torfinns/Autotrim/analysis/calibration_analysis.png

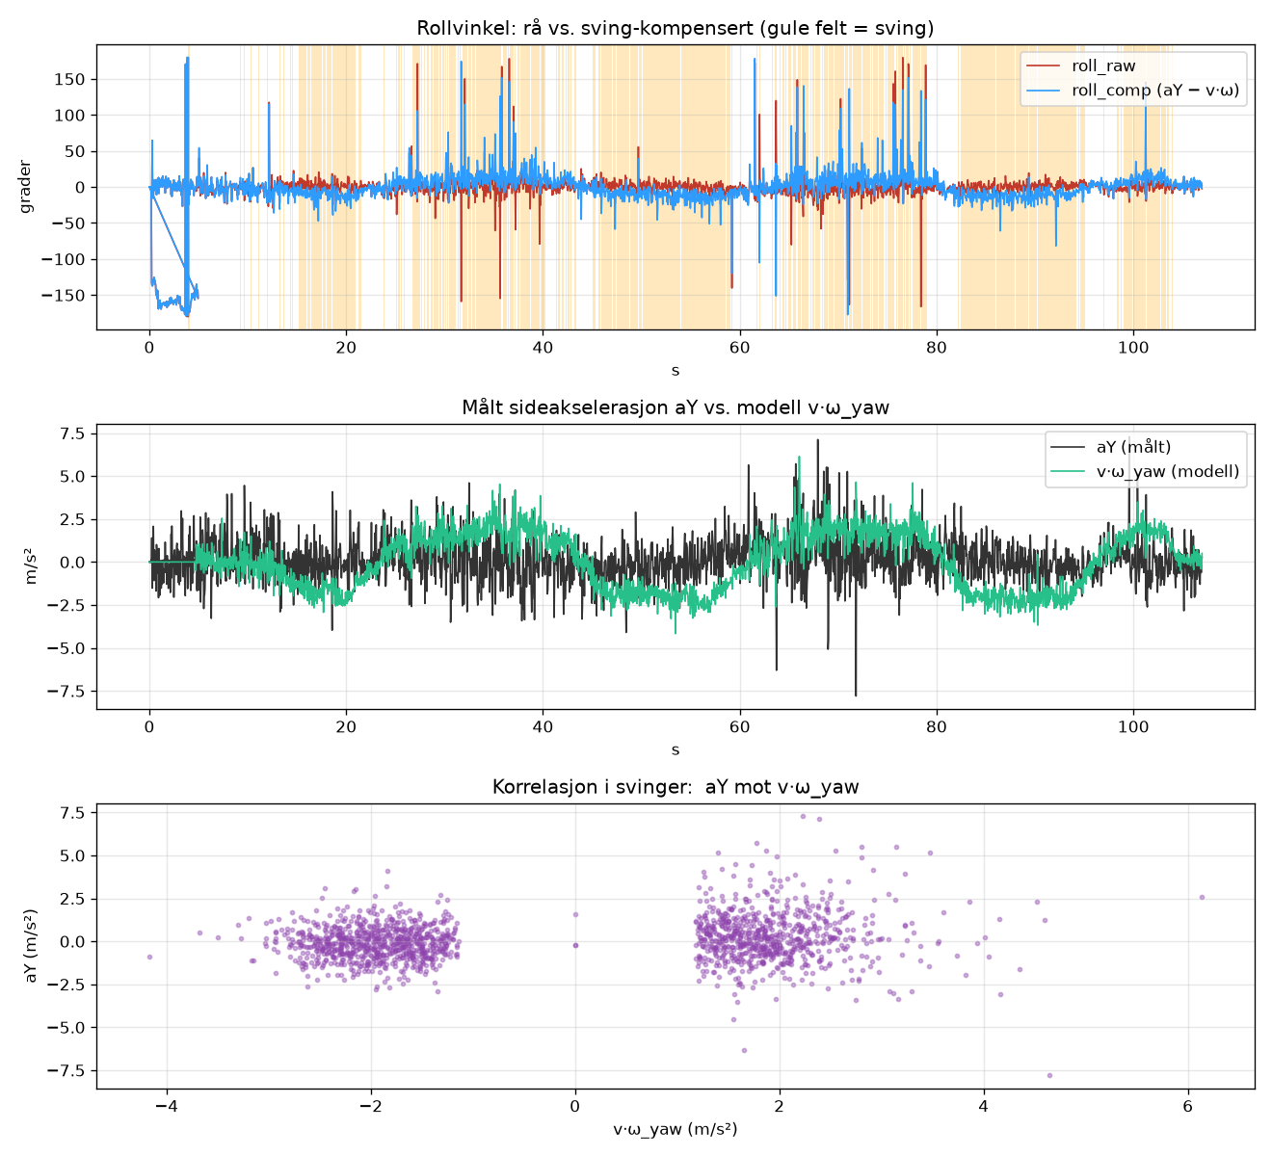
analysis/calibration_analysis.png
