torfinns/Autotrim/analysis/calibration_analysis_med5.png

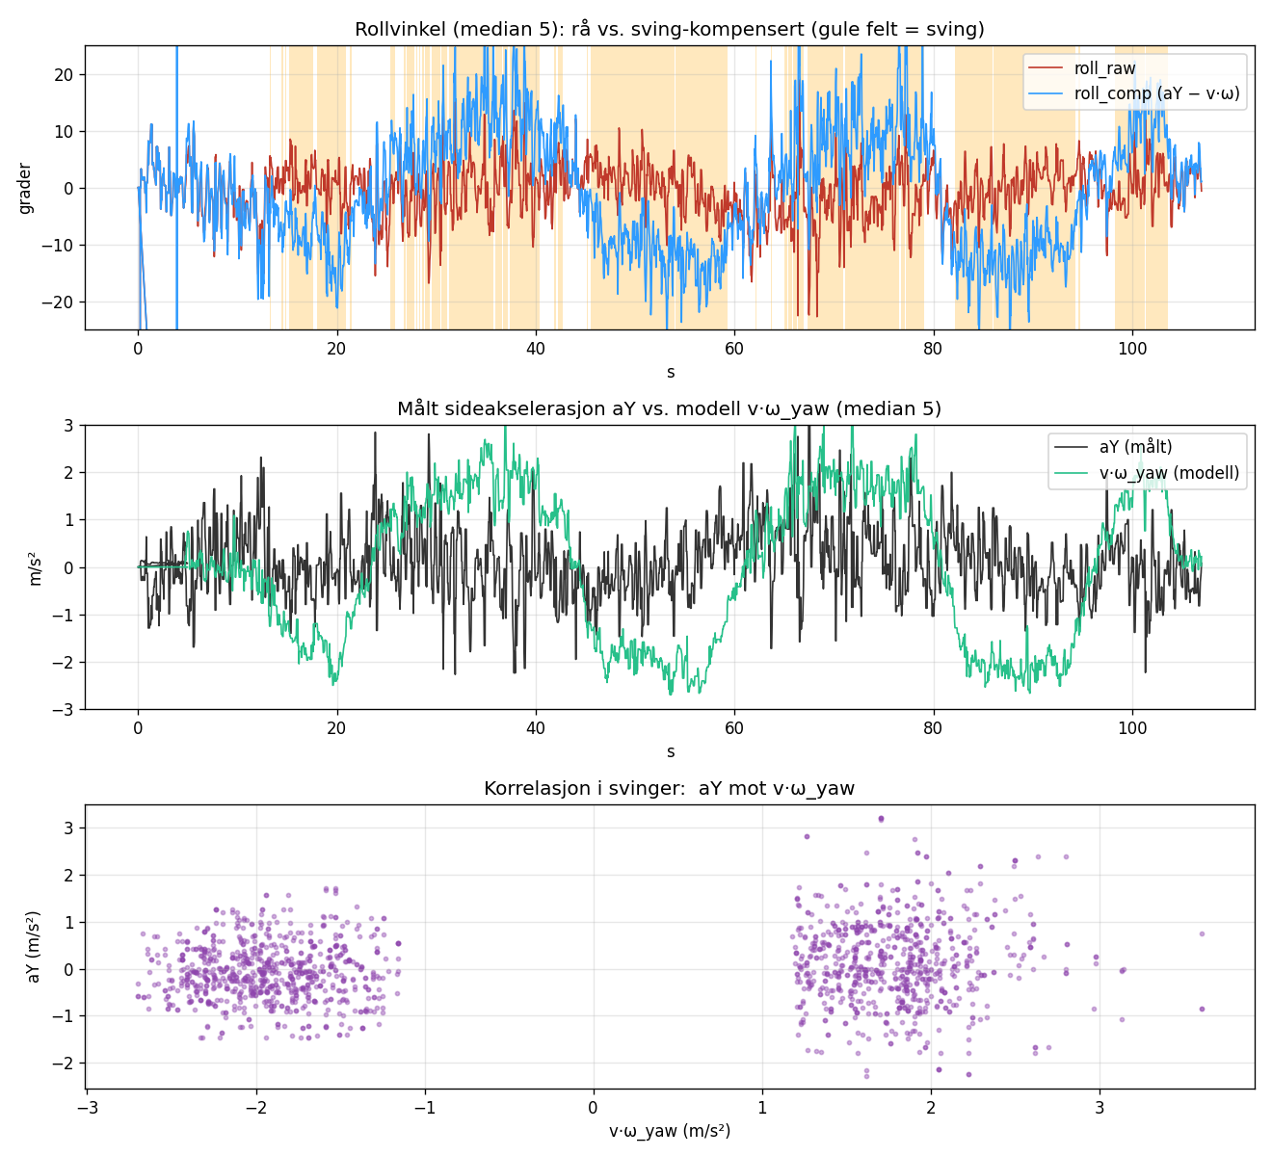
analysis/calibration_analysis_med5.png
