torfinns/Autotrim/(commit log)

2026-06-27 Fiks NimBLE-krasj: bruk 2.5.0 lokalt + NVS-recovery med restart
    Kopierer NimBLE-Arduino 2.5.0 til sketch-lokal libraries/ (system
    hadde 2.1.3 som krasjer med esp32-core 3.3.10 pga. mu->handle NULL
    i createServer). Auto-recovery sletter NVS og kaller ESP.restart()
    ved krasj slik at neste boot starter helt fra scratch.
2026-06-27 Legg til monteringsoffset, dotfill-streker og preset-meny
    - Firmware: AutotrimParams struct +4 bytes (mountingOffsetDeg float @ offset 52), PARAMS_VERSION→2
    - Firmware: offset brukes i telemetri, kontrollloop og serial debug
    - GUI: dotfill-streker mellom parameternavn og verdi i alle rader
    - GUI: ny parameter-rad for Monteringsoffset (°)
    - GUI: nedtrekksmeny med tre preset-sett (Fabrikk/Sport/Glatt)
    - GUI: PARAM_FIELDS og ArrayBuffer oppdatert til 56 bytes
2026-06-27 Gjør rollSign/gyroSign redigerbare i GUI
    Erstatter read-only visning med dropdown (-1/+1).
    loadParams() og buildParams() lese/skriver int8 ved offset 48/49.
2026-06-27 Minimum pådragstid 500ms; GUI: pos-bars vertikale; Drift+Test slått sammen; kP/kI ×100
    - Firmware: hold-timer per retning, 500ms min pådragstid i kontrollsløyfe
    - GUI: planposisjon vises som grønn strek fra topp → ned
    - GUI: Drift og Test slått til én fieldset, relay-knapper større, ingen Stopp-alle
    - GUI: kP og kI vises ×100 (GUI=6.0 → firmware 0.06); PARAM_FIELDS med scale-faktor
    - GUI: preset-verdier oppdatert til ny skala
    [autotrim_v1.ino]
2026-06-27 GUI: fjern Reléer-kort; relay-knapper lyser grønt; LEFT/RIGHT/NEUTRAL
    - Reléer-ramme fjernet fra dashboard
    - Relay-knapper lyser grønt når aktivt (manuelt eller automatikk)
    - Knapper: LEFT UP/DOWN, RIGHT UP/DOWN
    - Nøytralknapp: NEUTRAL / HOME
    - Les på nytt → Les parametre
    - fFlags flyttet til Tilstand-kortet
2026-06-27 Fjern gyroSign — firmware bruker rollSign for begge akser
    gyroSign var redundant og kunne føre til at gyro og akselerometer
    motarbeidet hverandre i komplementærfilteret. Firmware bruker nå
    p.rollSign for begge. gyroSign-felt beholdes i struct (PARAMS_VERSION=2)
    men ignoreres; GUI sender rollSign-verdien til offset 49 også.
2026-06-27 Diskret pulse-og-vent kontroll — stopper jaging mellom opp og ned
    Gammel logikk integrerte ved 20 Hz mens baten brukte sekunder pa a reagere,
    noe som bygde opp for mye krav og ga konstant ping-pong mellom opp og ned.
    Ny arkitektur: en beslutning -> rele kjorer -> vent 1.5s til rele er ferdig
    og baten har stabilisert seg -> ny beslutning. Ingen ny kommando er mulig
    mens hold-timere kjorer eller settle-timer teller ned. kP x CTRL_STEP_DT=0.5s
    bestemmer pulsstarrelse per korreksjonssyklus.
2026-06-27 Fix: ingen regulering innenfor dodbandet
    Posisjonstracker (posXMs) traff aldri nodvendig noyaktig tgtXMs, slik at
    regulatoren skot rele for a fikse en mismatch selv nar rullvinkelen var
    innenfor dodbandet. Fikset ved a bryte ut umiddelbart nar eMag==0.
    [autotrim_v1.ino]
2026-06-27 Anti-windup + BOOT_UP kjorer lenge nok til planene er helt oppe
    Anti-windup: naar feilens retning motstrider akkumulert _trimFrac
    (eMag * _trimFrac < 0) nullstilles _trimFrac slik at regulatoren
    starter fra noytralt — ingen motbakke ved retningsskifte.
    BOOT_UP: hardkodet 3000ms var kortere enn fullStrokeMs (6000ms default),
    slik at planene bare gikk halvveis opp. Naa brukes max(3000, fullStrokeMs*1.2).
2026-06-27 Fjern kI og cmdTauSec fra GUI; fix stale settleMs i dodbandet
    GUI: kI og cmdTauSec er ubrukte i ny kontrollarkitektur — fjernet fra
    PARAM_FIELDS, parametervisning og presets. Struct-bytesene beholdes
    uendret (ingen protokollendring).
    Firmware bug: naar eMag==0 (inne i dodbandet) fortsatte _settleMs aa
    telle ned og blokkerte neste korreksjon naar feilen kom tilbake.
    Nullstilles naa naar vi bryter ut i dodbandet.
    [autotrim_v1.ino]
2026-06-27 Aggressiv korreksjon ved stor feil (>3 grader)
    Liten feil (<=3deg): 500ms puls, 1.5s settle — rolig innregulering.
    Stor feil (>3deg): hold-timer settes til hele posisjonsavviket (maks 4s),
    settle = 500ms. Planet kjorer direkte til mal i en puls uten pause.
2026-06-27 Fix: PIN_BNO_RST = -1 (RST ikke koblet til ESP32)
    GPIO4 ble toglet LOW/HIGH ved oppstart, men BNO055 RST-pinnen
    henger i luften. Chip ble sittende i reset. Setter -1 slik at
    firmware hopper over reset-sekvensen og BNO055 bruker intern POR.
    [autotrim_v1.ino]
2026-06-27 Oppdater README: PIN_BNO_RST=-1, RST ikke koblet til ESP32
2026-06-28 Firmware: én rollSign (gyro-geometri i kode), BLE-hardning (ingen bonding + deleteAllBonds + watchdog re-init), homing 1s, fullStroke 5000ms. Slett duplikat app/-dashbord. Oppdater README/IO/arkitekt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
2026-06-28 Fjern anti-windup; GUI: Left/Right → Babord/Styrbord
    Anti-windup reset _trimFrac til 0 ved retningsskifte, selv for
    støy på deadband-grensen — plan ble kjørt opp uten grunn.
    Position-deadbåndet (120 ms) absorberer slike mikroskifter.
    [autotrim_v1.ino]
2026-06-29 Fix jaging: proporsjonal relay-puls, MIN_RELAY_ON_MS=100ms < POS_DEADBAND_MS
    500ms minimumspuls >> POS_DEADBAND_MS (120ms) → overshoot utløste
    ny korreksjon i motsatt retning → hunting. Ny SET_RELAY bruker
    constrain(delta, MIN, MAX) så overshoot alltid < POS_DEADBAND_MS.
    [autotrim_v1.ino]
2026-07-18 Snu opp/ned: pin-swap + relayInvert-parameter + GUI-toggle
    GPIO-pins LU/LD og RU/RD byttet (hardware-fix, verifisert 2026-07-18).
    relayInvert-parameter (offset 51, erstatter reserved1) for programvare-
    invert ved omvendt kobling. Toggle under Avanserte innstillinger i GUI.
    [autotrim_v1.ino]
2026-07-21 Firmware: sving-release (A) — median-5 på accel, yaw-rate fra gyro-X, fartsadaptiv v·ω sving-inhibering + retraher-til-nøytral med hysterese. Kalibreringslogger + analyseskript. Figurer: SIP-1A03, ka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
    [calib.csv]
2026-07-21 Fix truncated firmware fil fra forrige commit (setup/loop kuttet midt i ESP.restart())
    Forrige commit hadde en truncert snapshot av autotrim_v1.ino (kjent
    fil-sync-felle, se PROSJEKTSTATUS.md). Full fil er nå flashet til MCU
    og verifisert i drift. README oppdatert: sving-release-logikk,
    median-5-filter, korrekt rollSign=-1, faktisk BLE-watchdog-oppførsel.
    Legger til PROSJEKTSTATUS.md (gjenopptakspunkt) og relekort.drawio
    (kilde for relekort-figuren).
    [autotrim_v1.ino]
2026-07-23 Fiks sving-inhibering-brist fra sjøtest: absolutt yaw-gulv + failsafe maks-tid
    Sjøtest 2026-07-18 avdekket at sving-release låste seg permanent under
    planing (40-82% "i sving" pga bølge-/kursholdings-yaw), slik at slagside
    ble målt men aldri korrigert. Fiks: krev yaw-rate over absolutt gulv
    (arm 12 dps / slipp 7 dps) i tillegg til lateralakselerasjonen, og en
    hard maks-tid (4 s) som failsafe mot permanent lås. Verifisert med
    analysis/sim_control.py (40-82% -> <2% "i sving").
    Dashboard: robust tall-parsing (komma/punktum, minus via ±-knapp) med
    rød varsling på ugyldig input i stedet for stille 0.
    Docs oppdatert til å reflektere funn og fiks.
    [autotrim_v1.ino, sim_control.py]
